rexionmars/kaelix-firmware/docs/TCC/pre-textuais/abrev.tex

%%%%%%%%%%%%%%%%%%%%%%%%%%%%%%%%%%%%%%%%%%%%%%%%%%%%%%%%%%%%%%%%%%%%%%%%%%%%%%%
%% Lista de Siglas e Abreviaturas (pacote glossaries)
%%
%% Contém apenas as siglas efetivamente usadas nas seções 1 a 5 e no apêndice.
%% Acrescentar entrada aqui ao introduzir sigla nova no texto.
%%%%%%%%%%%%%%%%%%%%%%%%%%%%%%%%%%%%%%%%%%%%%%%%%%%%%%%%%%%%%%%%%%%%%%%%%%%%%%%

%% Instrumentação
\newacronym{MEMS}{MEMS}{sistemas microeletromecânicos (\emph{Micro-Electro-Mechanical Systems})}
\newacronym{IMU}{IMU}{unidade de medição inercial (\emph{Inertial Measurement Unit})}
\newacronym{BPFO}{BPFO}{frequência de passagem de esferas na pista externa (\emph{Ball Pass Frequency, Outer race})}
\newacronym{BPFI}{BPFI}{frequência de passagem de esferas na pista interna (\emph{Ball Pass Frequency, Inner race})}
\newacronym{DLPF}{DLPF}{filtro passa-baixas digital (\emph{Digital Low-Pass Filter})}

%% Normalização
\newacronym{ISO}{ISO}{Organização Internacional de Normalização (\emph{International Organization for Standardization})}

%% Detecção e avaliação
\newacronym{ROC}{ROC}{característica de operação do receptor (\emph{Receiver Operating Characteristic})}
\newacronym{AUC}{AUC}{área sob a curva (\emph{Area Under the Curve})}
\newacronym{pAUC}{pAUC}{área parcial sob a curva, restrita a uma faixa de falso alarme}
\newacronym{PRAUC}{PR-AUC}{área sob a curva de precisão e revocação}
\newacronym{TPR}{TPR}{taxa de detecção (\emph{True Positive Rate})}
\newacronym{DFT}{DFT}{transformada discreta de Fourier (\emph{Discrete Fourier Transform})}
\newacronym{FFT}{FFT}{transformada rápida de Fourier (\emph{Fast Fourier Transform})}
\newacronym{FPR}{FPR}{taxa de falso alarme (\emph{False Positive Rate})}

%% Computação embarcada e comunicação
\newacronym{TinyML}{TinyML}{aprendizado de máquina em dispositivos de recursos limitados}
\newacronym{LoRa}{LoRa}{modulação de longo alcance e baixa potência (\emph{Long Range})}
\newacronym{SF}{SF}{fator de espalhamento (\emph{Spreading Factor})}
\newacronym{CRC}{CRC}{verificação cíclica de redundância (\emph{Cyclic Redundancy Check})}
\newacronym{SRAM}{SRAM}{memória estática de acesso aleatório (\emph{Static Random-Access Memory})}
\newacronym{I2C}{I2C}{circuito interintegrado (\emph{Inter-Integrated Circuit})}
\newacronym{SPI}{SPI}{interface serial periférica (\emph{Serial Peripheral Interface})}
\newacronym{USB}{USB}{barramento serial universal (\emph{Universal Serial Bus})}
\newacronym{FIFO}{FIFO}{memória em que o primeiro dado a entrar é o primeiro a sair (\emph{First In, First Out})}
\newacronym{NaN}{NaN}{valor que indica ausência de número (\emph{Not a Number})}

%% Taxas de decisão, descritores e parâmetros do enlace, usados em forma literal no texto.
\newacronym{BW}{BW}{largura de banda (\emph{Bandwidth})}
\newacronym{CR}{CR}{taxa de codificação (\emph{Coding Rate})}
\newacronym{FC}{FC}{fator de crista}
\newacronym{FN}{FN}{falso negativo}
\newacronym{FP}{FP}{falso positivo}
\newacronym{VN}{VN}{verdadeiro negativo}
\newacronym{VP}{VP}{verdadeiro positivo}

%%%%%%%%%%%%%%%%%%%%%%%%%%%%%%%%%%%%%%%%%%%%%%%%%%%%%%%%%%%%%%%%%%%%%%%%%%%%%%%
%% O pacote glossaries só imprime as siglas EFETIVAMENTE USADAS via \gls{...}.
%% Como o texto dos capítulos usa as siglas em forma literal (e não \gls{}),
%% \glsaddall força todas as entradas acima para a lista impressa.
%%
%% Se no futuro o texto passar a usar \gls{}, remova a linha abaixo para que a
%% lista volte a conter apenas o que é citado.
%%%%%%%%%%%%%%%%%%%%%%%%%%%%%%%%%%%%%%%%%%%%%%%%%%%%%%%%%%%%%%%%%%%%%%%%%%%%%%%
\glsaddall
