rexionmars/kaelix-firmware/docs/TCC/pre-textuais/folha-aprovacao.tex

%%%%%%%%%%%%%%%%%%%%%%%%%%%%%%%%%%%%%%%%%%%%%%%%%%%%%%%%%%%%%%%%%%%%%%%%%%%%%%%
%% Folha de aprovação --- modelo iCEV, com os membros da banca (NBR 14724).
%%
%% Depois da defesa, troque o ambiente abaixo pelo PDF da folha assinada:
%%   \usepackage{pdfpages}   (em preambulo/pacotes.tex)
%%   \begin{folhadeaprovacao}
%%     \includepdf{folha-aprovacao-assinada.pdf}
%%   \end{folhadeaprovacao}
%%%%%%%%%%%%%%%%%%%%%%%%%%%%%%%%%%%%%%%%%%%%%%%%%%%%%%%%%%%%%%%%%%%%%%%%%%%%%%%

\begin{folhadeaprovacao}
	\begin{center}
		{\ABNTEXchapterfont\bfseries\imprimirautor}
		\vspace*{\fill}\vspace*{\fill}
		\begin{center}
			\ABNTEXchapterfont\bfseries\imprimirtitulo
		\end{center}
		\vspace*{\fill}
		\icevnatureza
		\vspace*{\fill}
	\end{center}

	\noindent{\bfseries\imprimirlocal, \underline{\hspace{0.8cm}} de \underline{\hspace{2.5cm}} de 20\underline{\hspace{0.5cm}}}

	\assinatura{\bfseries\imprimirorientador \\ Professor Orientador \\ Titulação \\ Instituição}
	\assinatura{\bfseries Membro da banca \\ Titulação \\ Instituição}
	\assinatura{\bfseries Membro da banca \\ Titulação \\ Instituição}
\end{folhadeaprovacao}
