rexionmars/kaelix-firmware/docs/TCC/apendices/appenA.tex

%%%%%%%%%%%%%%%%%%%%%%%%%%%%%%%%%%%%%%%%%%%%%%%%%%%%%%%%%%%%%%%%%%%%%%%%%%%%%%%
%% Apêndice A --- Práticas de engenharia do firmware
%%
%% Valores conferidos em src/sensors/vibration.h, src/comms/lora.h,
%% src/ml/model.h, src/power/watchdog.h e training/tests/test_export_cpp.py.
%%%%%%%%%%%%%%%%%%%%%%%%%%%%%%%%%%%%%%%%%%%%%%%%%%%%%%%%%%%%%%%%%%%%%%%%%%%%%%%

\chapter{Práticas de engenharia do \emph{firmware}}
\label{ape:praticas}

Algumas práticas usadas no \emph{firmware} vêm de normas e da literatura de sistemas críticos.
Essas fontes servem aqui como referência. O Kaelix é um protótipo acadêmico e não passou por
nenhum processo de certificação.

\section{Fontes das práticas}
\label{sec:ape-escalas}

As normas setoriais classificam a criticidade de formas diferentes, e não há equivalência
normativa entre elas. A norma de aviônica classifica o \emph{software} pela severidade da
condição de falha e não atribui taxa de falha ao \emph{software} \cite{do178c}. A norma
genérica define faixas numéricas de medida de falha alvo \cite{iec61508}. A norma automotiva
combina severidade, exposição e controlabilidade \cite{iso26262}.

\section{Práticas adotadas}
\label{sec:ape-mecanismos}

Nenhuma das práticas abaixo exige componente adicional.

\textbf{Propagação de erro.} Cada função devolve um código de estado, e o pacote leva o código do
primeiro erro do ciclo. Sem esse código, uma leitura com falha chegaria ao receptor como uma leitura
normal \cite{esa1996,knight1986}.

\textbf{Saída só em caso de sucesso.} Quando a leitura do sensor falha, a função não escreve no
vetor de amostras. Assim, o detector não recebe zeros que pareçam uma máquina parada.

\textbf{Valor inválido explícito.} O valor eficaz vai como NaN quando não foi medido, porque zero
é uma leitura possível. O estado \texttt{UNKNOWN} indica que o dispositivo não avaliou a máquina.

\textbf{Versão no pacote.} O primeiro byte do pacote informa a versão do formato, e o receptor
recusa versões que não conhece.

\textbf{\emph{Watchdog}.} Um temporizador reinicia o dispositivo se um ciclo travar.

\textbf{Testes no computador.} As funções de processamento rodam sem o \emph{hardware}. Um teste
compara o escore do detector em C++ com o da biblioteca usada no treino, e outro compara o CRC
em C++ com uma implementação em Python.

\section{Limites das práticas}
\label{sec:ape-limites}

Essas práticas não substituem redundância de \emph{hardware}, e a suposição de independência
entre versões diversas de \emph{software} não se confirmou empiricamente \cite{knight1986}. Os
testes no computador não cobrem o comportamento do rádio nem o do sensor.
\emandamento{Nenhum registro de bancada provoca uma falha de propósito para testar a propagação
de erro no dispositivo.}
