rexionmars/kaelix-firmware/docs/guias/guide.md

# Guia de escrita científica

Guia de consulta para escrever e revisar o TCC em português, com uma seção sobre o
*Abstract*. Junta três camadas principais:

1. **Princípios de escrita científica** ensinados por Harvard e pelo MIT, adaptados ao
   português.
2. **Uso de palavras**, segundo o *Manual de Redação da Presidência da República* (3. ed.,
   2018), a referência oficial de norma padrão escrita no Brasil.
3. **Acentuação e hífen**, segundo o Acordo Ortográfico de 1990, obrigatório no Brasil desde
   2016.

Os exemplos de "antes" vêm do próprio TCC sempre que possível. A lista de verificação da
Seção 12 resume tudo para a revisão final. As fontes estão no fim, com o que cada uma
sustenta.

> **"Harvard" também é nome de estilo de referência.** O "Harvard style" é um sistema
> autor-data de citação, comum no Reino Unido. Ele não se aplica aqui: o TCC segue a
> NBR 10520:2023 (citações) e a NBR 6023:2025 (referências), que também são autor-data,
> mas com regras próprias. Este guia trata dos guias de *escrita* de Harvard, não desse
> estilo.

---

## 1. Escreva para o leitor

**Uma mensagem principal.** O guia de artigo do MIT (CommKit) pede que o trabalho tenha
uma mensagem principal que caiba em uma ou duas frases, e que o resumo, as figuras e as
conclusões a contenham explicitamente. Antes de revisar um capítulo, escreva essa frase.
Se não conseguir, o problema não é de redação.

**A maldição do conhecimento.** Steven Pinker, professor de Harvard, chama assim a
dificuldade de imaginar como é *não* saber o que você sabe. É a causa mais comum de texto
técnico obscuro: siglas não definidas, passos "óbvios" omitidos, termos usados antes de
serem explicados. O remédio é pedir a alguém de fora da área que leia e marque onde
travou, o que o CommKit do MIT também recomenda.

**Ajuste o jargão ao público.** O CommKit distingue o público amplo, que precisa de mais
contexto e menos jargão, do especialista, que quer chegar rápido aos métodos. A banca de
um TCC é mista: defina cada termo técnico na primeira ocorrência, mesmo os que parecem
básicos para você.

**Linguagem exata, não linguagem "acadêmica".** O material de escrita do curso 9.12 do
MIT resume a troca de hábito assim: em vez de usar linguagem que *soa* séria e
inteligente, use a que *se ajusta exatamente* ao conteúdo; em vez de cumprir número de
páginas, escreva para comunicar.

---

## 2. Estrutura: do texto inteiro ao parágrafo

### 2.1 Introdução: do geral à lacuna

O CommKit do MIT descreve a introdução como um funil: contexto amplo, contexto
específico, **lacuna de conhecimento**, e então a pergunta ou o objetivo que responde a
ela. Em engenharia, costuma-se formular objetivos; em ciência, perguntas.

O TCC já segue esse desenho no Capítulo 1: norma e custo, depois nó de baixo custo, depois
a lacuna no segundo elo da cadeia, e só então a tese.

### 2.2 Equilíbrio entre seções

O CommKit alerta para a discussão "proporcionalmente longa demais": quando ela cresce,
com muitas citações, o trabalho começa a parecer uma revisão de literatura ou um texto
especulativo. Cada seção deve ter peso compatível com o que sustenta.

### 2.3 Parágrafo: a frase-tópico

Harvard e MIT convergem neste ponto.

- O Writing Center de Harvard dá à frase-tópico **duas funções**: anunciar a ideia
  principal do parágrafo e mostrar como ele se liga ao argumento do texto.
- **Teste de especificidade** (blog do mesmo Writing Center): se a frase-tópico pudesse
  ser transplantada para um texto com outra tese, ela não é específica o bastante.
- O material do MIT diz que o leitor usa a frase-tópico "como se fosse o título" do
  parágrafo. O CommKit acrescenta que o leitor deve captar o ponto principal lendo só a
  primeira frase.

**Teste rápido:** leia apenas a primeira frase de cada parágrafo de um capítulo, em
sequência. Se o argumento fizer sentido assim, a estrutura está boa. Se você tiver pouco
tempo para revisar, o blog do Writing Center de Harvard recomenda revisar exatamente as
frases-tópico.

### 2.4 Organização por afirmações

O Writing Center de Harvard sugere decompor a tese em afirmações principais, cada
afirmação em subafirmações, e conferir se as frases-tópico enunciam essas afirmações. Isso
equivale a escrever o sumário antes do texto e depois verificar se o texto cumpre o
sumário.

### 2.5 Títulos de seção

O material do MIT mostra que uma lista longa de títulos no mesmo nível esconde a
estrutura, e que subtítulos a revelam. Agrupe as seções por função antes de numerá-las.

---

## 3. A frase

### 3.1 Informação velha no início, nova no fim

O artigo de Gopen e Swan, *The Science of Scientific Writing* (1990), é a base de boa
parte do que se ensina em Harvard e no MIT sobre frases.

- **Início da frase (posição de tópico):** a informação já conhecida, que liga a frase à
  anterior.
- **Fim da frase (posição de ênfase):** a informação nova, que você quer que o leitor
  retenha. O leitor dá peso natural ao que vem por último.
- **Sujeito e verbo próximos:** o leitor espera o verbo logo depois do sujeito. Cada
  palavra entre os dois adia o entendimento.

| Antes | Depois |
|---|---|
| A frequência de montagem, que decorre da rigidez do caminho entre a base, o ressalto e o corpo e da massa do conjunto, situa-se em 557 Hz. | A rigidez do caminho e a massa do conjunto situam a frequência de montagem em 557 Hz. |

Na segunda versão, sujeito e verbo ficam juntos, e o número novo, 557 Hz, cai na posição
de ênfase.

### 3.2 Uma ideia por frase

Gopen e Swan observam que uma frase fica longa demais quando tem mais candidatos à
posição de ênfase do que posições disponíveis. Se a frase tem dois números importantes,
provavelmente são duas frases.

### 3.3 Paralelismo

Itens de uma lista ou de uma comparação devem ter a mesma forma gramatical. O *Manual de
Redação* (seção 11.4) dedica uma seção aos erros de paralelismo.

| Antes | Depois |
|---|---|
| O método compara a integração no tempo, a integração na frequência e se o viés altera o resultado. | O método compara a integração no tempo, a integração na frequência e o efeito do viés sobre o resultado. |

---

## 4. Concisão e escolha de palavras

### 4.1 Corte palavras que não trabalham

Esta tabela adapta ao português as listas do curso do MIT ("needless complexity" e
"needless words"). Ela também segue o *Manual de Redação* (seção 3.3): conciso é o texto
que transmite o máximo de informação com o mínimo de palavras, sem cortar o que é
substancial.

| Evite | Prefira |
|---|---|
| realizar a medição de | medir |
| efetuar a análise de | analisar |
| fazer a implementação de | implementar |
| tomar a decisão de | decidir |
| possui a capacidade de | pode |
| a utilização de | o uso de |
| com o objetivo de | para |
| devido ao fato de que | porque |
| no presente trabalho | neste trabalho |
| já existente | existente |
| continua a permanecer | permanece |
| completamente eliminado | eliminado |
| período de tempo | período |
| em um primeiro momento | primeiro |
| elo de ligação | elo |

O MIT chama de **verbos fracos** construções como "fazer a medição" ou "realizar o
desenvolvimento". O verbo forte ("medir", "desenvolver") é mais curto e mais claro.

### 4.2 Adjetivos e advérbios de ênfase

O *Manual de Redação* (seção 3.3) mostra um parágrafo inflado por "impressionante",
"esmagadora" e "indubitável" e o reescreve sem eles. Em texto científico, o número
substitui o adjetivo:

| Antes | Depois |
|---|---|
| A integração no tempo erra enormemente. | A integração no tempo erra em 73 %. |
| O detector tem desempenho muito ruim em desalinhamento. | O detector detecta 5,0 % ± 3,1 % do desalinhamento horizontal. |

O CommKit do MIT faz a mesma exigência para o resumo: resultados quantificados, e não
descritos em termos gerais.

### 4.3 Voz ativa, voz passiva e impessoalidade

O MIT recomenda a voz ativa por ser mais curta e mais direta. O exemplo do curso é "The
oscilloscope displayed the voltage", em vez de "The voltage was displayed by the
oscilloscope". O guia da Biblioteca de Harvard acrescenta que a passiva pode esconder
quem é responsável pela ação. Os dois admitem a passiva quando o agente não importa, o
que é comum em métodos.

Em português acadêmico há uma exigência a mais, a impessoalidade (*Manual de Redação*,
seção 3.5). A solução que atende as duas é a **voz ativa com sujeito inanimado**:

| Evite | Prefira |
|---|---|
| Nós medimos o falso alarme e vimos que... | O falso alarme medido foi de 2,0 %... |
| Foi verificado, por meio da análise realizada, que... | A análise mostra que... |
| Pode-se observar na Tabela 3 que... | A Tabela 3 mostra que... |

O *Manual de Redação* também condena o abuso do pronome "se" como indeterminador ("para
se atingir-se..."): o infinitivo sozinho já é impessoal. Escolha um registro, terceira
pessoa ou primeira do plural, e mantenha-o no trabalho inteiro.

**Tempo verbal.** Na prática comum dos guias de escrita científica, introdução e
discussão ficam no presente, para o que é tomado como verdade geral ("a norma exige"), e
métodos e resultados no pretérito perfeito, para o que foi feito ("o detector marcou").

### 4.4 Expressões a evitar

Todas as entradas desta tabela estão na seção 12.2 do *Manual de Redação*, salvo
indicação em contrário.

| Evite | Prefira | Observação |
|---|---|---|
| "o mesmo" como pronome ("o sensor falhou e o mesmo foi trocado") | ele, este, ou elimine | Gera ambiguidade. "O mesmo modelo" (adjetivo) está correto. |
| "onde" sem ideia de lugar ("a lei onde se fixa a pena") | em que, no qual | "Onde" é só para lugar físico. "Frequência onde nada existe" → "frequência em que nada existe". |
| "a nível de" | em nível de, no que se refere a | Modismo. |
| "a partir de" sem sentido de tempo ("a partir das cotas do desenho") | com base em | O Manual reserva a expressão para o sentido temporal. |
| "face a" | em face de, diante de | |
| "enquanto que" | enquanto, ao passo que | |
| "inclusive" com sentido de "até" | até, também | |
| "junto a" fora do sentido físico ("declarar junto à Receita") | declarar à Receita | |
| "nem tampouco", "não... nem não" | nem | Dupla negação. |
| "posto que" como causa | porque, já que | "Posto que" é concessivo: significa "embora". |
| "à medida em que", "na medida que" | à medida que (proporção); na medida em que (causa) | Cruzamento de duas locuções. |
| "operacionalizar", "agilizar" repetidos | realizar, executar, fazer | O problema é o excesso. |

**"Cerca de" com número não redondo.** O *Manual de Redação* (seção 12.1) diz que "cerca
de" indica número aproximado ou arredondado e não deve acompanhar números que não sejam
redondos. O TCC tinha casos assim, corrigidos na revisão de 30 out. 2026:

| No TCC (antes) | Revisão |
|---|---|
| dissipa cerca de 0,41 W | dissipa até 0,41 W (ou: aproximadamente 0,41 W) |
| a resolução é de cerca de 1,95 Hz | a resolução é de 1,95 Hz (valor calculado, 1000/512, apenas arredondado) |
| cerca de 0,063 m/s² | aproximadamente 0,063 m/s² |
| acima de cerca de 3,3 kHz | acima de aproximadamente 3,3 kHz |

### 4.5 Parônimos que mudam o sentido

| Forma | Significa | Exemplo |
|---|---|---|
| **a fim de** | para, com a finalidade de | Decimou-se o sinal a fim de emular a banda. |
| **afim** | semelhante, relacionado | Áreas afins. |
| **acerca de** | sobre, a respeito de | Discute-se acerca do limiar. |
| **há cerca de** | faz aproximadamente | O sensor foi lançado há cerca de dez anos. |
| **em vez de** | em lugar de | Usou-se a pAUC em vez da AUC. |
| **ao invés de** | ao contrário de (oposição) | Ao invés de melhorar, o desempenho caiu. |
| **a princípio** | no começo | A princípio, supôs-se que o invólucro limitava. |
| **em princípio** | em tese | Em princípio, o método vale para qualquer banda. |
| **há** (tempo passado) | faz | O ensaio ocorreu há dois meses. |
| **a** (tempo futuro, distância) | daqui a | O ensaio ocorrerá daqui a dois meses. |
| **mau** / **mal** | adjetivo (oposto de bom) / advérbio (oposto de bem) | Mau contato; o sensor está mal fixado. |
| **senão** / **se não** | caso contrário, exceto / caso não | Configure o filtro, senão há rebatimento. Se não configurar o filtro, há rebatimento. |

As seis primeiras estão na seção 12.1 do Manual, e o par a princípio/em princípio na
seção 12.2. Os pares há/a, mau/mal e senão/se não seguem a norma padrão geral.

### 4.6 Estrangeirismos e itálico

O *Manual de Redação* (seção 10.2) manda pôr em itálico as palavras estrangeiras **não
incorporadas** ao português. Ele também cita exemplos que dispensam destaque porque já
são de uso comum (internet, mouse, déficit). O que importa é a consistência.

O TCC era inconsistente: *software* estava sempre em itálico, e hardware, firmware e
benchmark nunca. Havia duas regras possíveis:

- **Opção A:** itálico em todos os termos em inglês (*software*, *hardware*,
  *firmware*, *benchmark*, *pipeline*, *standby*).
- **Opção B:** sem itálico para os termos já consagrados em engenharia (software,
  hardware, firmware) e itálico para os demais.

**Decisão (30 out. 2026): opção A**, aplicada ao texto inteiro. Termo novo em inglês
entra em itálico.

Não ponha itálico em nomes próprios, siglas e nomes de produto (Isolation Forest, LoRa,
ESP32-S3).

### 4.7 Siglas

Escreva por extenso na primeira ocorrência, com a sigla entre parênteses: "unidade de
medição inercial (IMU)". Depois use só a sigla. O CommKit do MIT pede que **legendas de
figura** também definam toda sigla e símbolo, porque a legenda deve ser lida sem o texto.
No TCC, a lista de siglas vem de `pre-textuais/abrev.tex`.

---

## 5. Figuras, tabelas e legendas

As regras do CommKit do MIT para figuras:

1. A figura deve se explicar sozinha. Pergunte se a mensagem principal fica clara só pela
   figura.
2. A legenda deve explicar a figura sem depender do texto.
3. Defina na legenda toda sigla e todo símbolo, e evite siglas quando puder.
4. Faça figuras preliminares cedo: elas revelam onde faltam testes ou experimentos.

Para o desenho em si (normas ISO e ABNT de desenho técnico, cor, unidades), siga
o guia de plotagem.

---

## 6. Uso de fontes

O *Harvard Guide to Using Sources* organiza o uso de fontes em três formas: **resumir**,
**parafrasear** e **citar literalmente**. Segundo a descrição do guia, as ciências
naturais usam sobretudo resumo e paráfrase; a citação literal fica para quando a
formulação exata importa, como na definição de uma norma.

Regras práticas:

- **Toda forma exige atribuição.** Paráfrase sem citação é plágio, mesmo com outras
  palavras.
- **Paráfrase de verdade** muda a estrutura, não só as palavras. Feche a fonte, escreva de
  memória e só depois confira.
- **Citação literal curta** (até três linhas) fica no corpo do texto, entre aspas. A
  longa vai em bloco recuado; desde a NBR 10520:2023, o recuo de 4 cm é recomendado, e
  não obrigatório.
- **Citação traduzida por você** leva "tradução nossa" na chamada: (Gopen; Swan, 1990,
  p. 552, tradução nossa).
- **Cite o que você leu.** Se só leu o resumo, diga isso. O TCC já faz isso nas notas das
  referências ("Texto integral não acessado").

---

## 7. Acentuação e hífen

### 7.1 O que o Acordo de 1990 mudou

As regras e os exemplos desta seção vêm do tutorial da reforma ortográfica da Câmara dos
Deputados.

| Regra | Antes | Agora |
|---|---|---|
| Ditongos abertos **éi** e **ói** em paroxítonas perdem o acento | idéia, heróico, assembléia, apóio | ideia, heroico, assembleia, apoio |
| **i** e **u** tônicos depois de ditongo, em paroxítonas, perdem o acento | feiúra, Bocaiúva | feiura, Bocaiuva |
| Terminações **êem** e **ôo(s)** perdem o acento | lêem, crêem, vôo, perdôo | leem, creem, voo, perdoo |
| Somem os acentos diferenciais pára, péla, pólo, pêlo, pêra | Ele pára o carro. | Ele para o carro. |
| O trema desaparece (exceto em nomes estrangeiros: Müller) | freqüência, tranqüilo, cinqüenta | frequência, tranquilo, cinquenta |

**O que continua acentuado:**

- **Oxítonas e monossílabos com éi, éu, ói** continuam acentuados: herói, troféu, papéis,
  dói. A regra que caiu vale só para paroxítonas.
- **i e u tônicos em posição final de oxítona** continuam: Piauí, tuiuiú.
- **pôde** (passado) × **pode** (presente): "Ontem ele não pôde sair, mas hoje pode."
- **pôr** (verbo) × **por** (preposição).
- **Plural de ter e vir e derivados:** ele tem / eles têm; ele vem / eles vêm; ele mantém
  / eles mantêm; ele contém / eles contêm.
- **fôrma** × forma: o acento é facultativo.

### 7.2 As regras básicas, para não errar por omissão

O erro mais comum em texto digitado é a falta de acento, e não o acento errado.

- **Proparoxítonas:** todas são acentuadas. Exemplos: análise, técnica, científica,
  média, módulo, índice, código, dígito, protótipo, máquina, numérico, término, síntese,
  próximo, físico.
- **Paroxítonas** são acentuadas quando terminam em:

  | Terminação | Exemplos |
  |---|---|
  | -l | útil, fácil, possível, variável, nível, móvel |
  | -n | hífen, pólen |
  | -r | caráter, éter |
  | -x | tórax |
  | -ps | bíceps |
  | -ã(s), -ão(s) | ímã, ímãs, órgão |
  | -i(s), -us | lápis, vírus, bônus |
  | -um, -uns | álbum |
  | ditongo | frequência, série, água, área, espécie, rádio |

  **Não** se acentuam paroxítonas terminadas em -a, -e, -o, -em, -ens: medida, rede,
  modelo, item, itens. Por isso o singular leva acento e o plural não: hífen/hifens,
  pólen/polens.
- **Oxítonas** são acentuadas quando terminam em -a(s), -e(s), -o(s), -em, -ens: até,
  após, também, porém, através, alguém, parabéns.

### 7.3 Palavras do TCC que costumam perder o acento

> análise · técnica · científica · frequência · média · índice · módulo · código ·
> protótipo · rolamento (sem acento) · vibração · aquisição · precisão · resolução ·
> elétrico · térmico · mecânico · estatístico · espectral (sem acento) · amplitude (sem
> acento) · ímã/ímãs · têm/tem · contém/contêm · pôde · experiência · referência ·
> eficiência · potência · tensão · ressonância · hipótese · síntese · conclusão ·
> padrões · possível · útil · único · só · já · até · também · após · através

### 7.4 Hífen com prefixo

Pelo tutorial da Câmara e pela regra geral do Acordo:

| Regra | Exemplos |
|---|---|
| Prefixo terminado em vogal + palavra iniciada por **r** ou **s**: **sem hífen**, dobra a consoante | antirrebatimento, antirruído, autossustentável, semissupervisionado, contrarregra |
| Prefixo terminado em vogal + palavra iniciada por **vogal diferente**: sem hífen | autoaquecimento, extraoficial, infraestrutura, semiautomático |
| Prefixo terminado em vogal + **mesma vogal**: com hífen | micro-ondas, anti-inflamatório, semi-interno |
| Palavra iniciada por **h**: com hífen | anti-higiênico, super-homem |
| **pré-, pós-, pró-** tônicos: sempre com hífen | pré-carga, pós-processamento |
| sub- + **b** ou **r**: com hífen | sub-base, sub-região (mas subamostragem) |

**No TCC:** "anti-rebatimento" aparecia duas vezes e foi corrigido para
"**antirrebatimento**" em 30 out. 2026. "Pré-carga", "autoaquecimento" e
"semissupervisionada" já estavam corretos.

### 7.5 Crase

A crase é a fusão da preposição **a** com o artigo **a**. O teste é trocar a palavra
feminina por uma masculina: se aparecer "ao", há crase.

- **Há crase:** "relativo à banda" (relativo ao sinal); "à medida que"; "às vezes"; "devido
  à temperatura" (devido ao calor).
- **Não há crase** antes de palavra masculina ("a partir do ensaio"), de verbo ("começou a
  medir"), de pronome pessoal ("refere-se a ela") e em "a partir de", com qualquer
  palavra.
- **Regência:** "ajustar **às** normas", "adequar **à** NBR 6023": "ajustar a" + "as
  normas".

---

## 8. Números, unidades e símbolos

Estas regras seguem a brochura do SI (BIPM, 9. ed., 2019). No TCC, o `siunitx` aplica a
maioria delas sozinho, desde que se use `\SI{...}{...}` e `\num{...}`.

- **Vírgula decimal:** 0,5, e não 0.5.
- **Espaço entre número e unidade:** 15 kW, 557 Hz. No LaTeX: `\SI{557}{\hertz}`.
- **O símbolo de porcentagem também leva espaço:** 2,0 %. No LaTeX: `\SI{2,0}{\percent}`.
- **Símbolos de unidade não têm plural nem ponto:** 5 kg, e não "5 kgs" nem "5 kg.".
- **Grandeza em itálico, unidade em redondo:** *f*<sub>n</sub> = 557 Hz.
- **Faixas:** "10 Hz a 1000 Hz", ou `\SIrange{10}{1000}{\hertz}`.
- **Incerteza:** a unidade precisa valer para os dois números: (75,0 ± 3,5) % ou
  75,0 % ± 3,5 %. A forma "75,0 ± 3,5 %" deixa a unidade só no segundo número. **Decisão
  (30 out. 2026):** o TCC usa "(75,0 ± 3,5) %", já configurado no `\sisetup` de
  `preambulo/pacotes.tex`; basta escrever `\SI{75,0 \pm 3,5}{\percent}`. No `siunitx`, `\SI{75,0 \pm 3,5}{\percent}` sai, por padrão, como
  "75,0(35) %". Com `uncertainty-mode = separate` e `separate-uncertainty-units = bracket`
  no `\sisetup`, sai "(75,0 ± 3,5) %"; com `= repeat`, sai "75,0 % ± 3,5 %". As duas
  formas foram testadas.
- **Por extenso ou com símbolo, nunca misturado:** "15 quilowatts" ou "15 kW", e não
  "15 quilo-W".
- **Números no início da frase** (convenção de estilo, não do SI): escreva por extenso ou
  reescreva a frase. "Quarenta dos 41 estudos...", ou "Dos 41 estudos, 40...".

---

## 9. Abstract em inglês

### 9.1 Estrutura

O CommKit do MIT divide o resumo em seis componentes, de poucas frases cada, somando
"algumas centenas de palavras":

1. **Contexto amplo**, que interessa a todo o público.
2. **Contexto específico**, que leva ao seu problema.
3. **Lacuna:** qual é a pergunta de pesquisa?
4. **Frase de solução:** o que você fez e como responde à lacuna. O guia sugere começar
   com "Here we show".
5. **Abordagem e resultados**, com números.
6. **Implicações:** por que importa e o que vem depois.

O resumo deve ser compreensível sem o resto do trabalho: a maioria dos leitores decide
pelo título e pelo resumo.

### 9.2 Falsos cognatos comuns em texto técnico

| Português | Inglês correto | Armadilha |
|---|---|---|
| atualmente | currently | *actually* = na verdade |
| eventualmente (às vezes) | occasionally | *eventually* = por fim |
| realizar (um ensaio) | carry out, perform, run | *realize* = perceber |
| pretender | intend | *pretend* = fingir |
| sensível | sensitive | *sensible* = sensato |
| norma (técnica) | standard | *norm* = norma social |
| assistir | watch, attend | *assist* = ajudar |
| dado(s) | data (plural), a data point | *datum* é raro |
| bancada de ensaio | test rig, test bench | |
| ensaio | test | *essay* = redação |
| tese (TCC) | thesis, capstone project | |

### 9.3 Consistência de grafia

O *Abstract* atual usa grafia britânica (*standardised*, *synthesised*, *modelling*).
Está correta, mas precisa ser consistente: uma única palavra americana (*standardized*,
*modeling*) quebra o padrão. Escolha uma variante e mantenha-a no texto inteiro.

---

## 10. Normas ABNT que tocam a redação

- **Citações (NBR 10520:2023):** autor em caixa alta e baixa, também entre parênteses
  (Liu; Ting; Zhou, 2008); *et al.* e *apud* em itálico. O estilo
  `abntex2-alf-2025.bst` já faz isso; não escreva citações à mão.
- **Referências (NBR 6023:2025):** DOI como endereço completo, "Acesso em" só para página
  web. As convenções do `.bib` estão no cabeçalho de `referencias.bib`.
- **"Capítulo" ou "seção" (NBR 14724:2024):** fontes secundárias indicam que a edição de
  2024 adota só "seção", seguindo a NBR 6024. O TCC diz "Capítulo~\ref{...}" em 12
  lugares. **Confirme no texto da norma, ou com o orientador**, antes de trocar.
- **Resumo (NBR 6028:2021):** parágrafo único, voz ativa, sem citações, palavras-chave
  separadas por ponto e vírgula.

---

## 11. Erros recorrentes nas suas mensagens

Os padrões abaixo apareceram nas mensagens desta conversa, e não no TCC. Eles valem como
lista de autoconferência para quando você escreve rápido.

| Escrito | Correto | Regra |
|---|---|---|
| so, unico, monolitico, referencias, cientifica, padroes | só, único, monolítico, referências, científica, padrões | Acento omitido (7.2 e 7.3) |
| matendo | mantendo | Ortografia |
| afim de | a fim de | Parônimo (4.5) |
| ajusta as referências **para** as normas | ajuste as referências **às** normas | Regência e crase (7.5) |
| havard, pdf | Harvard, PDF | Nome próprio e sigla em maiúsculas |
| Analisa, pra | Analise, para | Registro: aceitável em conversa, não no texto formal |

O primeiro item é de longe o mais frequente. Ao revisar, faça uma passada só para acentos,
procurando as palavras da lista 7.3.

---

## 12. Lista de verificação

**Estrutura**
- [ ] A mensagem principal cabe em uma ou duas frases e aparece no resumo, nas figuras e
      nas conclusões.
- [ ] A introdução vai do contexto amplo à lacuna e só então à pergunta ou ao objetivo.
- [ ] Lendo só as frases-tópico de um capítulo, o argumento se sustenta.
- [ ] A discussão não domina o trabalho.

**Frase**
- [ ] Sujeito e verbo estão próximos.
- [ ] A informação nova está no fim da frase.
- [ ] Os itens de cada lista têm a mesma forma gramatical.
- [ ] Nenhuma frase carrega dois números importantes que deveriam estar separados.

**Palavras**
- [ ] Sem verbos fracos ("realizar a medição") nem expressões infladas (tabela 4.1).
- [ ] Adjetivos de ênfase foram trocados por números.
- [ ] Sem "o mesmo" como pronome, "onde" sem lugar, "a nível de", "a partir de" sem tempo.
- [ ] "Cerca de" só com número redondo.
- [ ] Itálico em estrangeirismos aplicado com uma regra única.
- [ ] Toda sigla está definida na primeira ocorrência e na legenda das figuras.

**Grafia**
- [ ] Passada só de acentos (lista 7.3).
- [ ] Hífen de prefixos conferido: antirrebatimento, e não anti-rebatimento.
- [ ] Crase conferida pelo teste do masculino.
- [ ] Unidades com `\SI`, vírgula decimal e espaço antes da unidade e do %.

**Fontes**
- [ ] Toda paráfrase tem citação.
- [ ] Citações traduzidas levam "tradução nossa".
- [ ] Nenhuma citação escrita à mão: tudo passa por `\cite` ou `\citeonline`.

**Abstract**
- [ ] Segue os seis componentes do CommKit e dá números.
- [ ] Sem falsos cognatos (tabela 9.2).
- [ ] Grafia britânica ou americana, nunca as duas.

---

## Fontes

Consultadas em 29 e 30 out. 2026.

**Harvard**

- HARVARD COLLEGE WRITING CENTER. *Anatomy of a Body Paragraph*. Fonte das duas funções
  da frase-tópico. https://writingcenter.fas.harvard.edu/anatomy-body-paragraph
- HARVARD COLLEGE WRITING CENTER. *Tips for Organizing Your Essay*. Fonte da
  decomposição da tese em afirmações.
  https://writingcenter.fas.harvard.edu/tips-organizing-your-essay
- HARVARD COLLEGE WRITING CENTER. *When you don't have much time to revise, focus on topic
  sentences*. Blog, 3 set. 2020. Fonte do teste de especificidade.
  https://harvardwritingcenterblog.com/2020/09/03/when-you-dont-have-much-time-to-revise-focus-on-topic-sentences/
- HARVARD COLLEGE WRITING PROGRAM. *Harvard Guide to Using Sources*. Fonte das três
  formas: resumo, paráfrase e citação.
  https://www.library.hbs.edu/citations/harvard-guide-to-using-sources
- HARVARD LIBRARY. *Writing Guide*. Fonte da voz ativa e do problema da
  responsabilidade oculta na passiva. https://library.harvard.edu/writing-guide
- PINKER, S. *The Sense of Style: the thinking person's guide to writing in the 21st
  century*. New York: Viking, 2014. Pinker é professor de psicologia em Harvard; fonte da
  "maldição do conhecimento".

Os sites do FAS de Harvard bloqueiam acesso automatizado. O conteúdo das três páginas do
Writing Center veio dos resumos indexados por mecanismos de busca, e não da leitura
integral das páginas.

**MIT**

- MIT COMMUNICATION LAB. *CommKit: Journal article*. Department of Civil and
  Environmental Engineering. Fonte da mensagem principal, das figuras autossuficientes, do
  peso das seções e da frase-tópico como resumo do parágrafo.
  https://mitcommlab.mit.edu/cee/commkit/journal-article/
- MIT COMMUNICATION LAB. *CommKit: Abstract*. Fonte dos seis componentes do resumo.
  https://mitcommlab.mit.edu/cee/commkit/abstract/
- OGREN, M. P. *Writing basics*. Material do curso 9.12, Experimental Molecular
  Neurobiology, MIT OpenCourseWare, 2006. Fonte das listas de palavras desnecessárias,
  dos verbos fracos, da voz ativa e da frase-tópico como título.
  https://ocw.mit.edu/courses/9-12-experimental-molecular-neurobiology-fall-2006/resources/writingbasics/
- PERELMAN, L.; BARRETT, E. *The Mayfield Handbook of Technical and Scientific Writing*.
  Burr Ridge: McGraw-Hill Higher Education, 1997. Recomendado no material do curso 9.12,
  com esta referência.

**Base comum**

- GOPEN, G. D.; SWAN, J. A. The science of scientific writing. *American Scientist*,
  v. 78, n. 6, p. 550-558, 1990. Fonte das posições de tópico e de ênfase e da proximidade
  entre sujeito e verbo. JSTOR 29774235.

**Português e normas**

- BRASIL. Presidência da República. *Manual de redação da Presidência da República*. 3.
  ed. Brasília: Presidência da República, 2018. Fonte dos atributos (seção 3), do itálico
  (10.2), do paralelismo (11.4), dos parônimos (12.1) e das expressões a evitar (12.2).
  Lido nesta cópia, de 189 páginas:
  https://files.ufgd.edu.br/arquivos/arquivos/78/PROTOCOLO/Normas%20Internas/Manual%20de%20Reda%C3%A7%C3%A3o%20da%20Presid%C3%AAncia%20da%20Rep%C3%BAblica%20-%203%C2%A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,%20revista,%20atualizada%20e%20ampliada.pdf
  A versão oficial é distribuída pelo Portal da Legislação (planalto.gov.br).
- CÂMARA DOS DEPUTADOS. *Tutorial: reforma ortográfica*. Brasília. Fonte das regras e dos
  exemplos da seção 7.
  https://www.camara.leg.br/internet/reformaortografica/versao_impressao_tutorial_ortografico.pdf
- BUREAU INTERNATIONAL DES POIDS ET MESURES. *The International System of Units (SI)*.
  9. ed. Sèvres: BIPM, 2019. Fonte da seção 8. https://www.bipm.org/en/publications/si-brochure
- ASSOCIAÇÃO BRASILEIRA DE NORMAS TÉCNICAS. NBR 10520:2023, NBR 6023:2025, NBR 6028:2021
  e NBR 14724:2024. Para as mudanças de 2023 e 2025, ver a revisão das referências feita
  em 29 out. 2026 e o cabeçalho de `abntex2-alf-2025.bst`.
