rexionmars/kaelix-firmware/experiments/figures/data/fig2e_roc.csv

fpr | tpr | auc | pauc | pauc_05 | banda | banda_curta
0.0 | 0.0 | 0.9997959183673469 | 0.9989258861439312 | 0.9979068550497121 | Sensor 20 kHz AUC 1.000 · pAUC 0.999 | Sensor 20 kHz
0.0 | 0.007142857142857143 | 0.9997959183673469 | 0.9989258861439312 | 0.9979068550497121 | Sensor 20 kHz AUC 1.000 · pAUC 0.999 | Sensor 20 kHz
0.0 | 0.02857142857142857 | 0.9997959183673469 | 0.9989258861439312 | 0.9979068550497121 | Sensor 20 kHz AUC 1.000 · pAUC 0.999 | Sensor 20 kHz
0.0 | 0.04285714285714286 | 0.9997959183673469 | 0.9989258861439312 | 0.9979068550497121 | Sensor 20 kHz AUC 1.000 · pAUC 0.999 | Sensor 20 kHz
0.0 | 0.06428571428571428 | 0.9997959183673469 | 0.9989258861439312 | 0.9979068550497121 | Sensor 20 kHz AUC 1.000 · pAUC 0.999 | Sensor 20 kHz
0.0 | 0.12857142857142856 | 0.9997959183673469 | 0.9989258861439312 | 0.9979068550497121 | Sensor 20 kHz AUC 1.000 · pAUC 0.999 | Sensor 20 kHz
0.0 | 0.21428571428571427 | 0.9997959183673469 | 0.9989258861439312 | 0.9979068550497121 | Sensor 20 kHz AUC 1.000 · pAUC 0.999 | Sensor 20 kHz
0.0 | 0.22142857142857142 | 0.9997959183673469 | 0.9989258861439312 | 0.9979068550497121 | Sensor 20 kHz AUC 1.000 · pAUC 0.999 | Sensor 20 kHz
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
