rexionmars/kaelix-firmware/experiments/figures/data/tab_deteccao_classes.csv

classe | massa_g | deteccao | desvio | janelas
horizontal-misalignment |  | 0.05012820512820513 | 0.030738232248488182 | 1773
imbalance |  | 0.7496708377305392 | 0.035370258014343056 | 2997
normal |  | 0.02 | 0.012957670877434 | 441
overhang-bearing |  | 0.4221799183535334 | 0.07781150889452515 | 4617
overhang-bearing | 0 | 0.20702973909870465 | 0.0699817591259201 | 1323
overhang-bearing | 20 | 0.6396296296296297 | 0.07758415051750346 | 1107
overhang-bearing | 35 | 0.7832804232804234 | 0.08224499694795837 | 918
overhang-bearing | 6 | 0.1952198503922642 | 0.09623218379701658 | 1269
underhang-bearing |  | 0.5589482339482339 | 0.033446286755102986 | 5022
underhang-bearing | 0 | 0.14848020434227333 | 0.04304839017047613 | 1332
underhang-bearing | 20 | 0.8198321474183542 | 0.02764438907339779 | 1323
underhang-bearing | 35 | 0.8728260869565216 | 0.05492188027801067 | 1053
underhang-bearing | 6 | 0.4617879948914432 | 0.04302851629775429 | 1314
vertical-misalignment |  | 0.07161505768063145 | 0.04276832724824457 | 2709
