rexionmars/kaelix-firmware/experiments/figures/data/fig2d_fora_do_treino.csv

ensaio_retido | contamination | falso_alarme
0 | auto | 1.0
0 | 0.01 | 1.0
1 | auto | 1.0
1 | 0.01 | 1.0
2 | auto | 1.0
2 | 0.01 | 1.0
3 | auto | 1.0
3 | 0.01 | 1.0
4 | auto | 1.0
4 | 0.01 | 1.0
