rexionmars/kaelix-firmware/experiments/figures/data/tab_deteccao_limiar.csv

limiar | falso_alarme | desvio
calibrado | 0.02 | 0.012957670877434
padrão | 0.31234567901234567 | 0.04243035840926408
