rexionmars/kaelix-firmware/experiments/figures/output/fig8_circuito_folha2.png

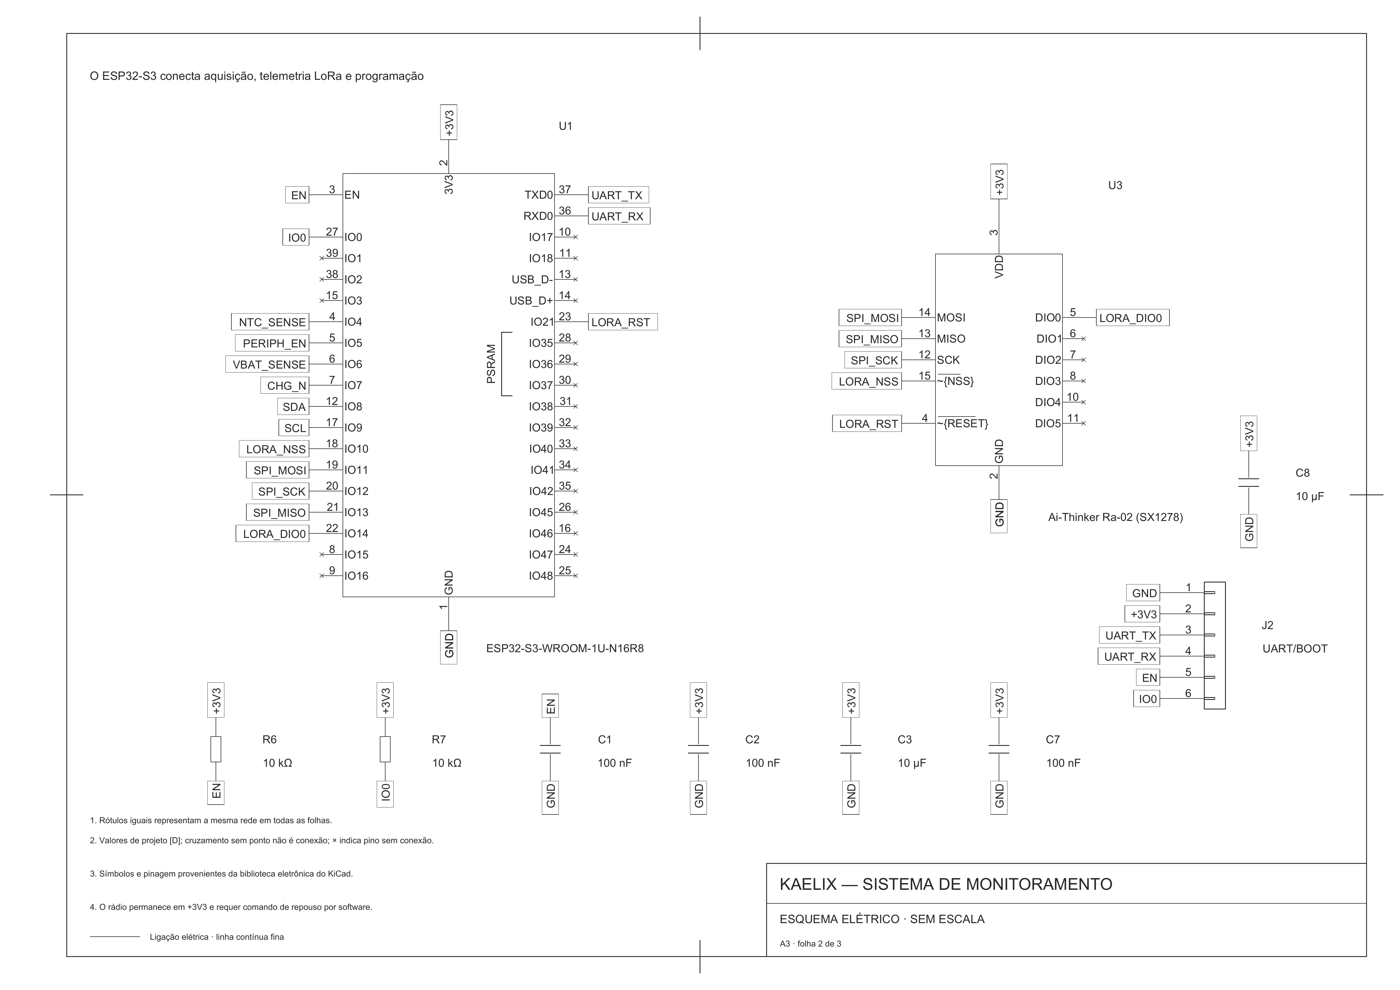
experiments/figures/output/fig8_circuito_folha2.png
