rexionmars/kaelix-firmware/experiments/figures/output/fig8_circuito_folha3.png

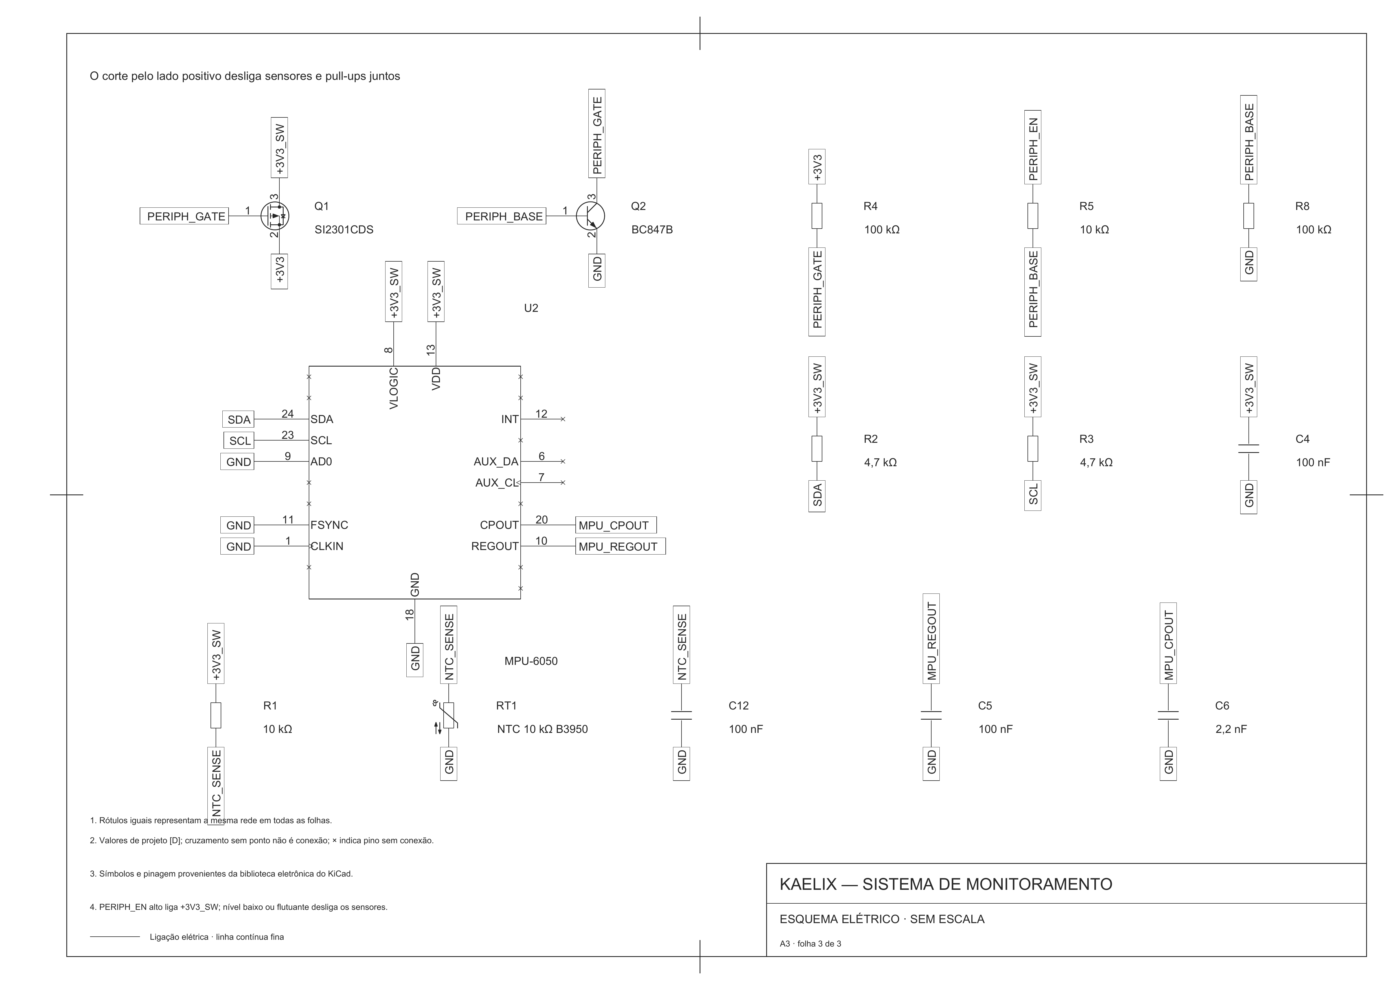
experiments/figures/output/fig8_circuito_folha3.png
