rexionmars/kaelix-firmware/experiments/figures/output/fig1_banda_sensor.pdf

a

b

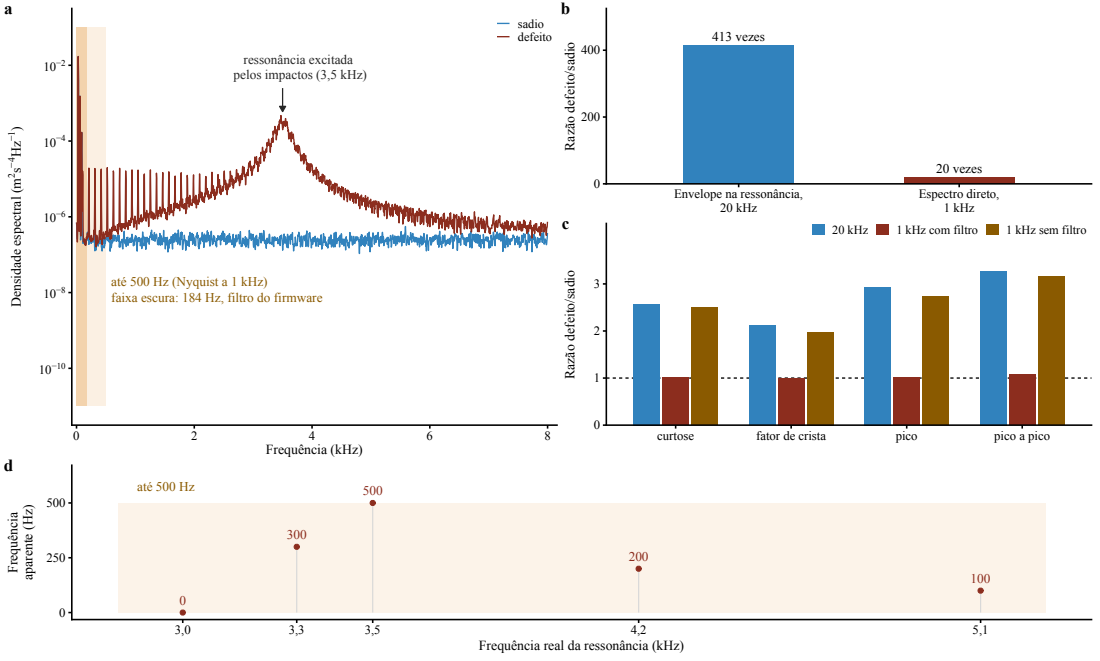
[picture p5: page 1]
Frequência (kHz); Densidade espectral (m2; sadio defeito; 413 vezes; 20 vezes; 20 kHz; Espectro direto, 1 kHz; curtose; fator de crista; pico; pico a pico; 1 kHz com filtro; 1 kHz sem filtro c; até 500 Hz; Frequência; aparente (Hz)

Razão defeito/sadio

ressonância excitada
pelos impactos (3,5 kHz)

Envelope na ressonância,

até 500 Hz (Nyquist a 1 kHz)
faixa escura: 184 Hz, filtro do firmware

Frequência real da ressonância (kHz)
