rexionmars/kaelix-firmware/experiments/figures/output/fig2_metodologia.pdf

a

b

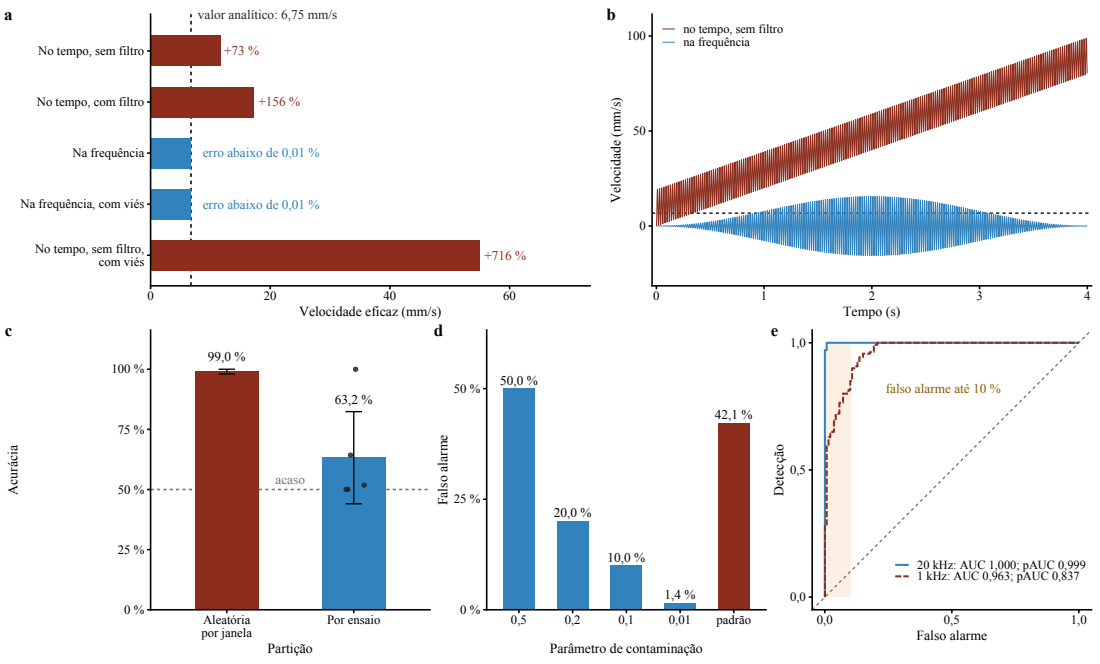
[picture p6: page 1]
com viés; Na frequência; Tempo (s); Velocidade (mm/s); acaso; Aleatória por janela; Por ensaio; Partição; Acurácia c; padrão; Falso alarme; Detecção

valor analítico: 6,75 mm/s

no tempo, sem filtro
na frequência

No tempo, sem filtro

No tempo, com filtro

erro abaixo de 0,01 %

Na frequência, com viés

No tempo, sem filtro,

Velocidade eficaz (mm/s)

falso alarme até 10 %

20 kHz: AUC 1,000; pAUC 0,999
1 kHz: AUC 0,963; pAUC 0,837

Parâmetro de contaminação
