rexionmars/kaelix-firmware/experiments/figures/output/fig8_circuito.pdf

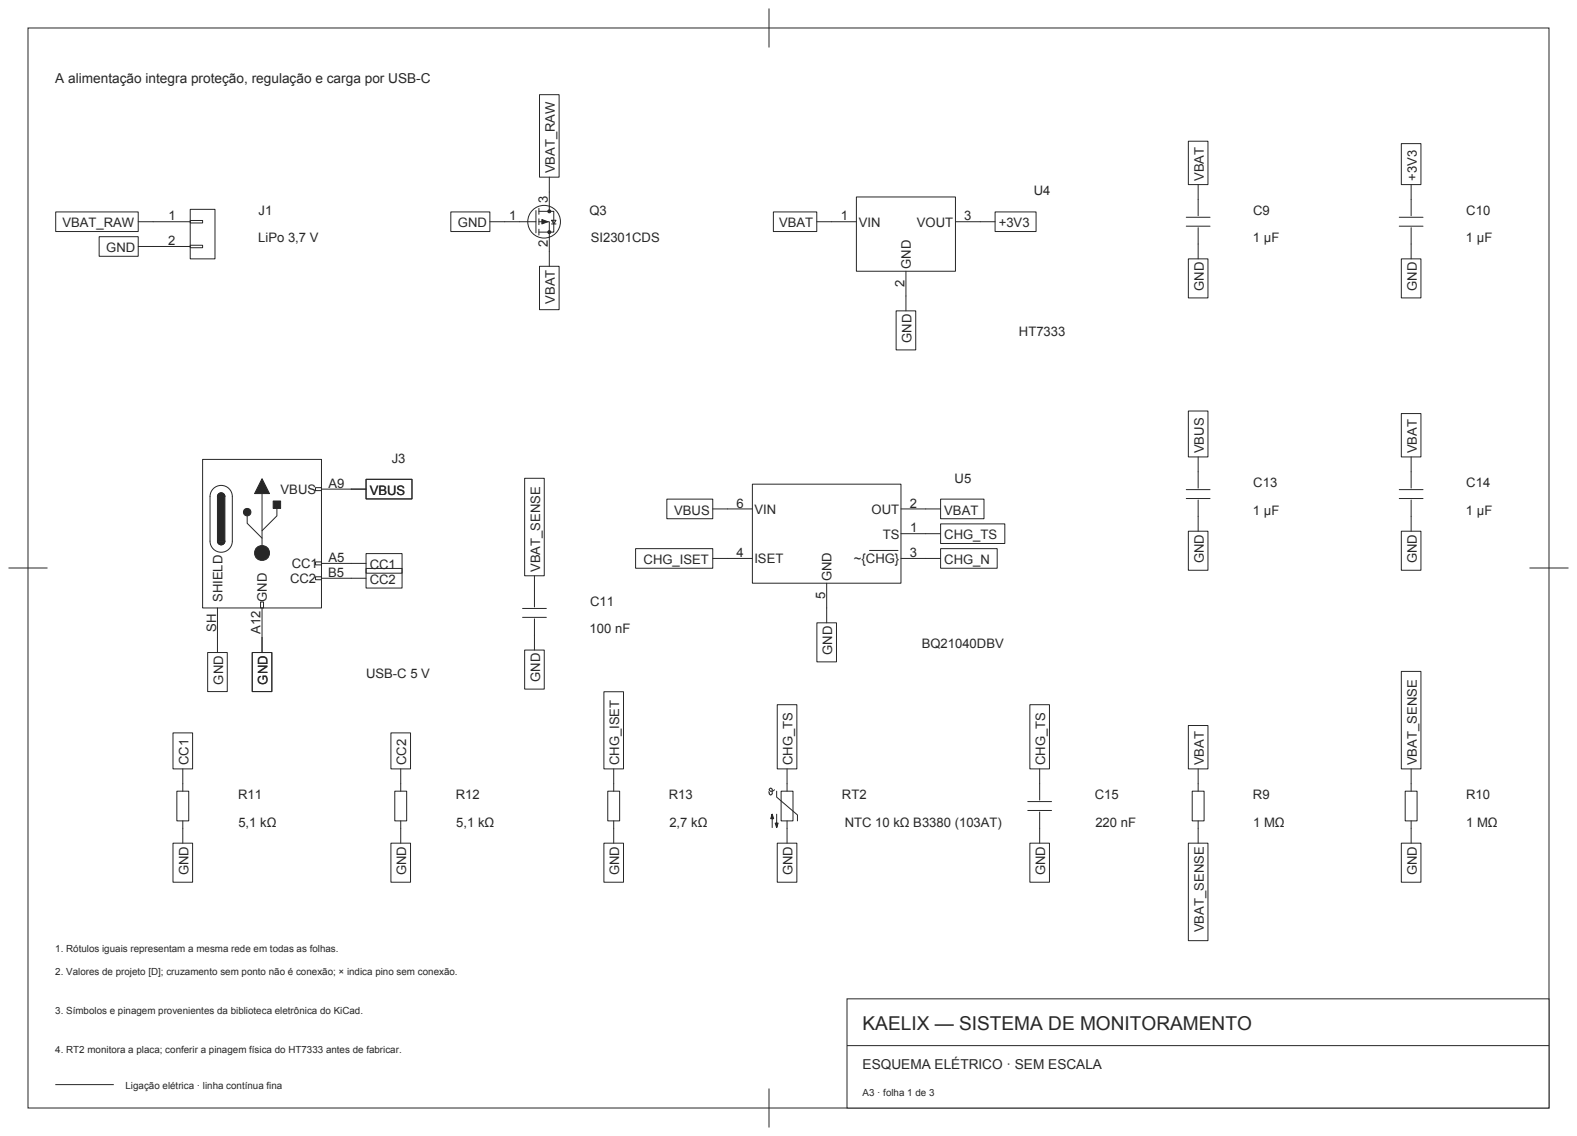
[picture p7: page 1]

A alimentação integra proteção, regulação e carga por USB-C

1. Rótulos iguais representam a mesma rede em todas as folhas.

2. Valores de projeto [D]; cruzamento sem ponto não é conexão; × indica pino sem conexão.

3. Símbolos e pinagem provenientes da biblioteca eletrônica do KiCad.

KAELIX — SISTEMA DE MONITORAMENTO

4. RT2 monitora a placa; conferir a pinagem física do HT7333 antes de fabricar.

ESQUEMA ELÉTRICO · SEM ESCALA

Ligação elétrica · linha contínua fina

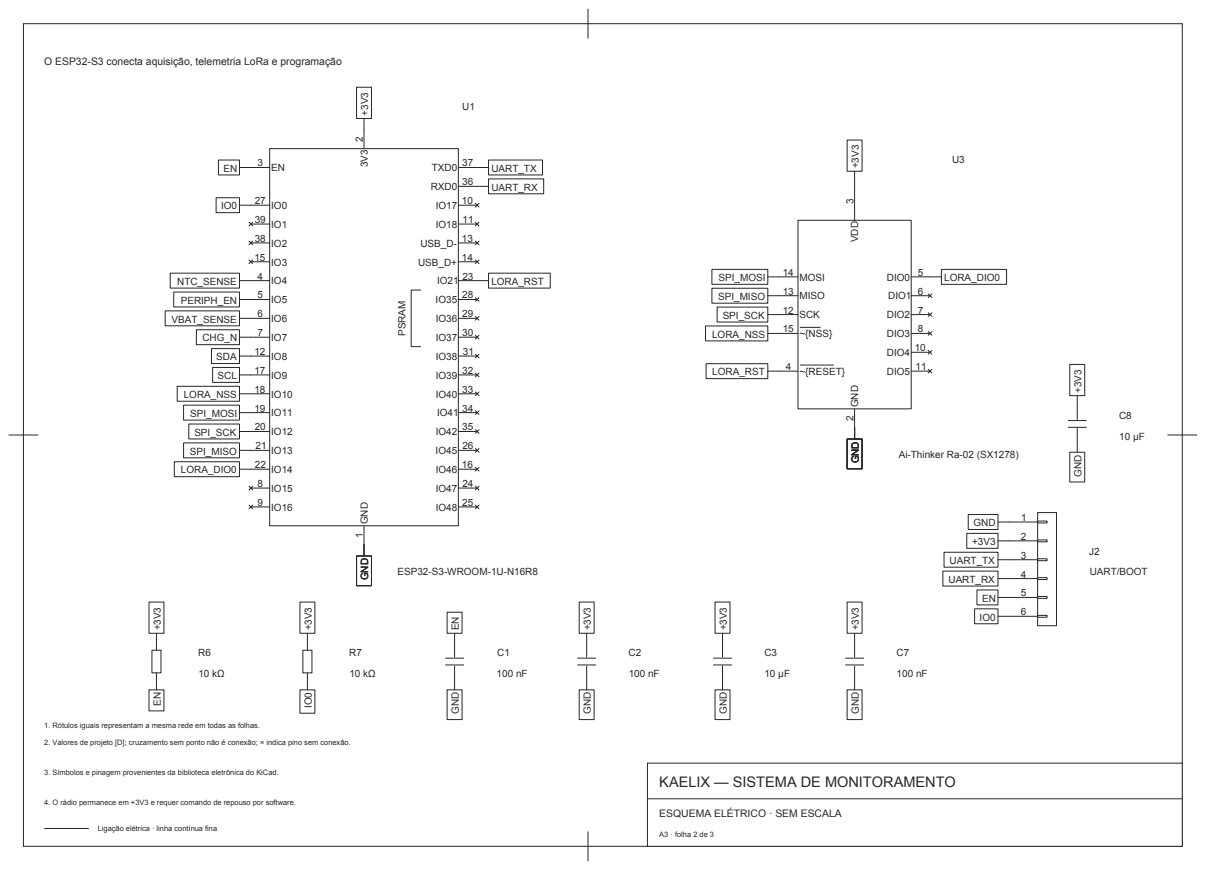
[picture p8: page 2]

O ESP32-S3 conecta aquisição, telemetria LoRa e programação

1. Rótulos iguais representam a mesma rede em todas as folhas.

2. Valores de projeto [D]; cruzamento sem ponto não é conexão; × indica pino sem conexão.

3. Símbolos e pinagem provenientes da biblioteca eletrônica do KiCad.

KAELIX — SISTEMA DE MONITORAMENTO

4. O rádio permanece em +3V3 e requer comando de repouso por software.

# MPU_REGOUT PERIPH_GATE

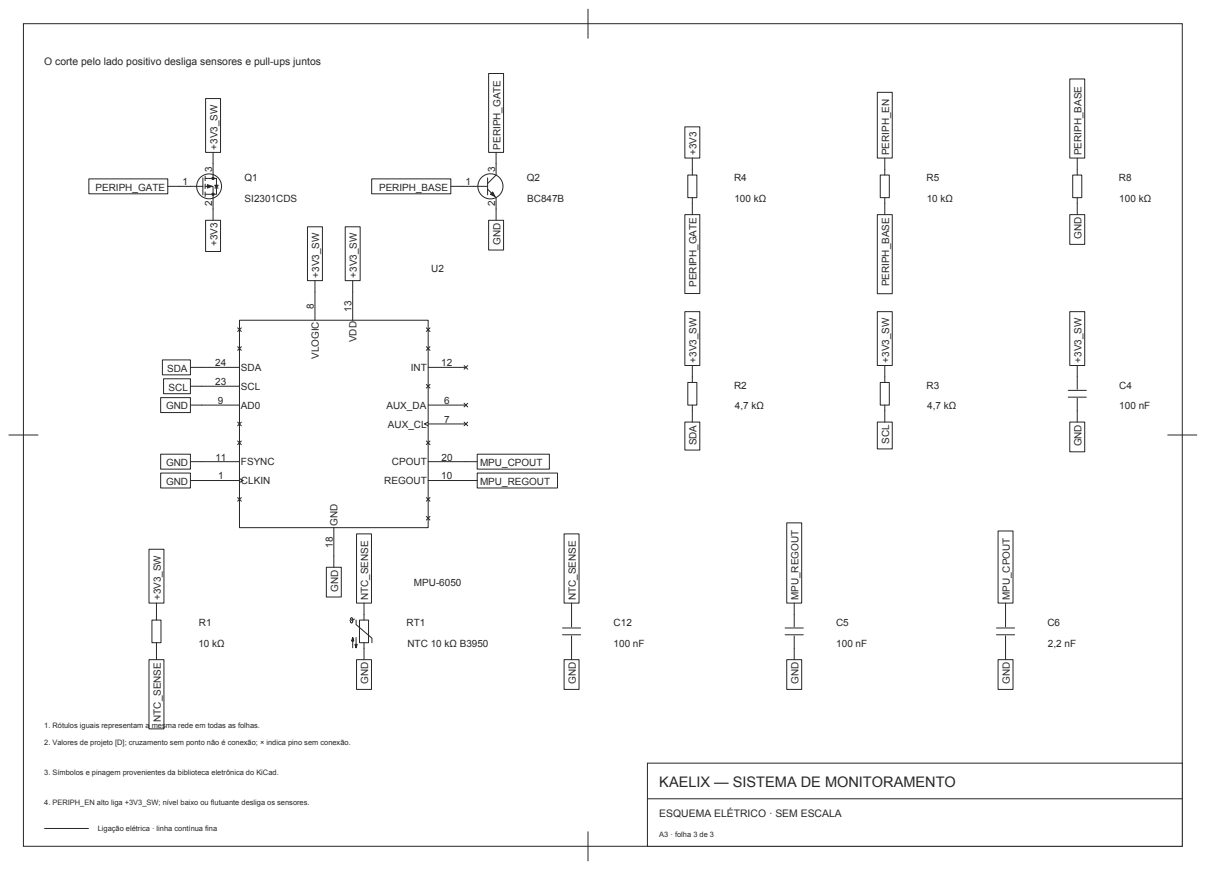
[picture p9: page 3]

O corte pelo lado positivo desliga sensores e pull-ups juntos

1. Rótulos iguais representam a mesma rede em todas as folhas.

2. Valores de projeto [D]; cruzamento sem ponto não é conexão; × indica pino sem conexão.

3. Símbolos e pinagem provenientes da biblioteca eletrônica do KiCad.

KAELIX — SISTEMA DE MONITORAMENTO

4. PERIPH_EN alto liga +3V3_SW; nível baixo ou flutuante desliga os sensores.
