rexionmars/kaelix-firmware/hardware/pcb/v3/prancha/folha1.kicad_sch

## KiCad design hardware/pcb/v3/prancha/folha1.kicad_sch (2026-10-09)

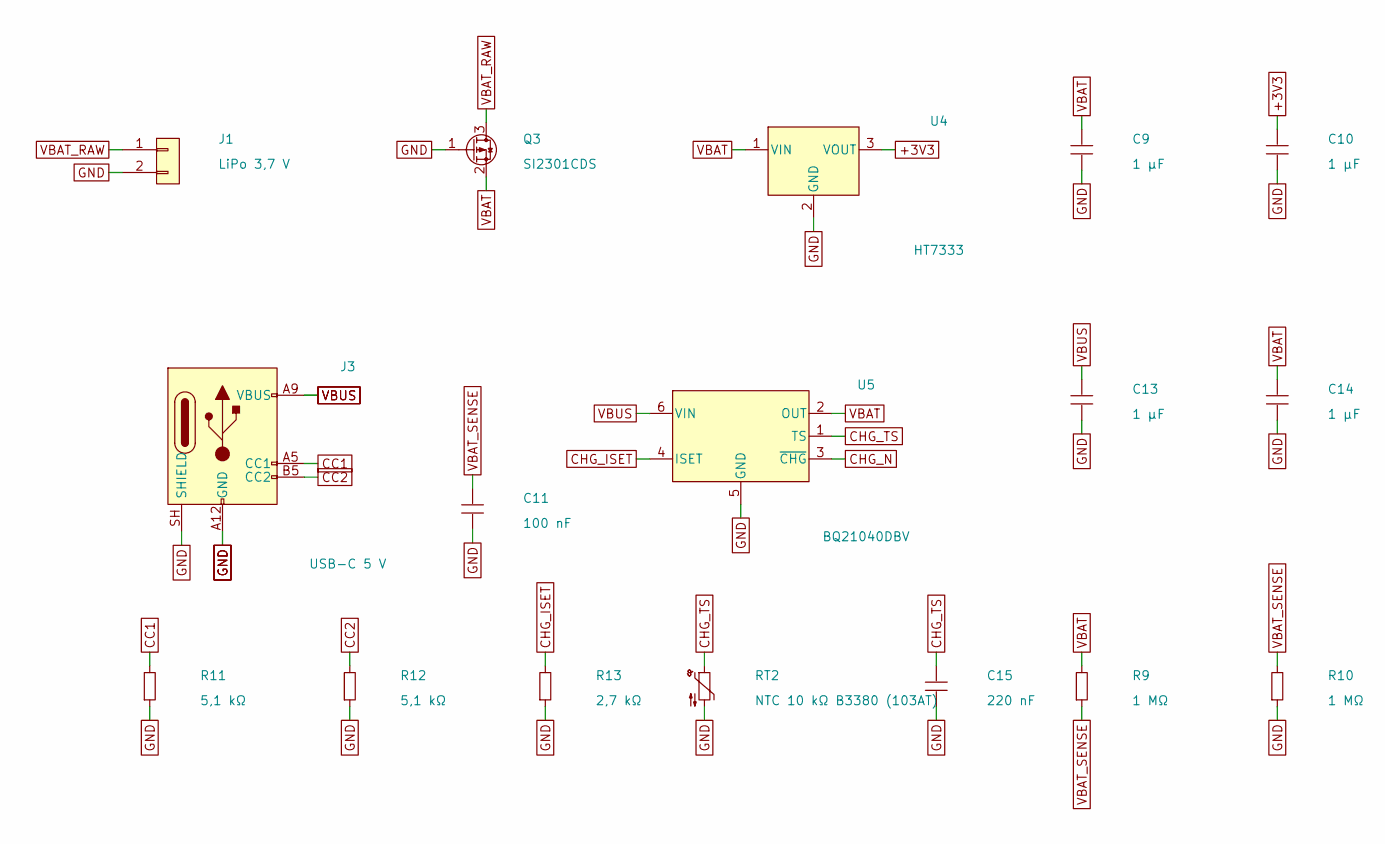
[picture p10: schematic folha1.kicad_sch]

Parts:
C9, C10, C13, C14: 1 µF; C_0805_2012Metric
C11: 100 nF; C_0805_2012Metric
C15: 220 nF; C_0805_2012Metric
J1: LiPo 3,7 V; JST_PH_S2B-PH-SM4-TB_1x02-1MP_P2.00mm_Horizontal
J3: USB-C 5 V; USB_C_Receptacle_GCT_USB4125-xx-x_6P_TopMnt_Horizontal
Q3: SI2301CDS; SOT-23
R9, R10: 1 MΩ; R_0805_2012Metric
R11, R12: 5,1 kΩ; R_0805_2012Metric
R13: 2,7 kΩ; R_0805_2012Metric
RT2: NTC 10 kΩ B3380 (103AT); R_0805_2012Metric
U4: HT7333; SOT-89-3
U5: BQ21040DBV; SOT-23-6

Connections:
+3V3: C10.1, U4.3 (VOUT)
CC1: J3.A5 (CC1), R11.1
CC2: J3.B5 (CC2), R12.1
CHG_ISET: R13.1, U5.4 (ISET)
CHG_N: U5.3 (~CHG)
CHG_TS: C15.1, RT2.1, U5.1 (TS)
GND: C9.2, C10.2, C11.2, C13.2, C14.2, C15.2, J1.2, J3.A12 (GND), J3.B12 (GND), J3.SH (SHIELD), Q3.1 (G), R10.2, R11.2, R12.2, R13.2, RT2.2, U4.2 (GND), U5.5 (GND)
VBAT: C9.1, C14.1, Q3.2 (S), R9.1, U4.1 (VIN), U5.2 (OUT)
VBAT_RAW: J1.1, Q3.3 (D)
VBAT_SENSE: C11.1, R9.2, R10.1
VBUS: C13.1, J3.A9 (VBUS), J3.B9 (VBUS), U5.6 (VIN)
