rexionmars/kaelix-firmware/hardware/pcb/v3/prancha/folha2.kicad_sch

## KiCad design hardware/pcb/v3/prancha/folha2.kicad_sch (2026-10-09)

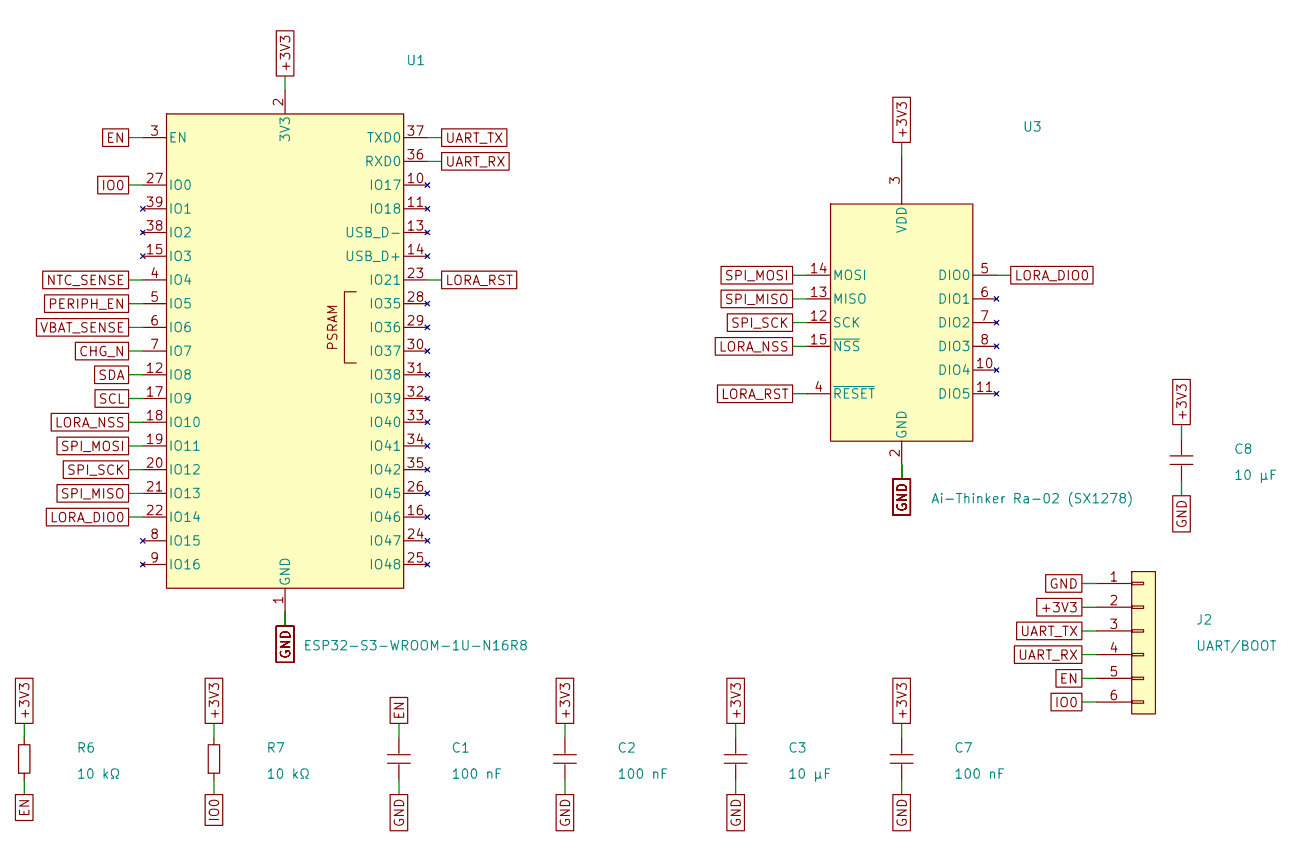
[picture p11: schematic folha2.kicad_sch]

Parts:
C1, C2, C7: 100 nF; C_0805_2012Metric
C3, C8: 10 µF; C_0805_2012Metric
J2: UART/BOOT; PinHeader_1x06_P2.54mm_Vertical
R6, R7: 10 kΩ; R_0805_2012Metric
U1: ESP32-S3-WROOM-1U-N16R8; ESP32-S3-WROOM-1U
U3: Ai-Thinker Ra-02 (SX1278); Ai-Thinker-Ra-01-LoRa

Connections:
+3V3: C2.1, C3.1, C7.1, C8.1, J2.2, R6.1, R7.1, U1.2 (3V3), U3.3 (VDD)
CHG_N: U1.7 (IO7)
EN: C1.1, J2.5, R6.2, U1.3 (EN)
GND: C1.2, C2.2, C3.2, C7.2, C8.2, J2.1, U1.1 (GND), U1.40 (GND), U1.41 (GND), U3.1 (GND), U3.2 (GND), U3.9 (GND), U3.16 (GND)
IO0: J2.6, R7.2, U1.27 (IO0)
LORA_DIO0: U1.22 (IO14), U3.5 (DIO0)
LORA_NSS: U1.18 (IO10), U3.15 (~NSS)
LORA_RST: U1.23 (IO21), U3.4 (~RESET)
NTC_SENSE: U1.4 (IO4)
PERIPH_EN: U1.5 (IO5)
SCL: U1.17 (IO9)
SDA: U1.12 (IO8)
SPI_MISO: U1.21 (IO13), U3.13 (MISO)
SPI_MOSI: U1.19 (IO11), U3.14 (MOSI)
SPI_SCK: U1.20 (IO12), U3.12 (SCK)
UART_RX: J2.4, U1.36 (RXD0)
UART_TX: J2.3, U1.37 (TXD0)
VBAT_SENSE: U1.6 (IO6)
