rexionmars/kaelix-firmware/hardware/pcb/v3/prancha/folha3.kicad_sch

## KiCad design hardware/pcb/v3/prancha/folha3.kicad_sch (2026-10-09)

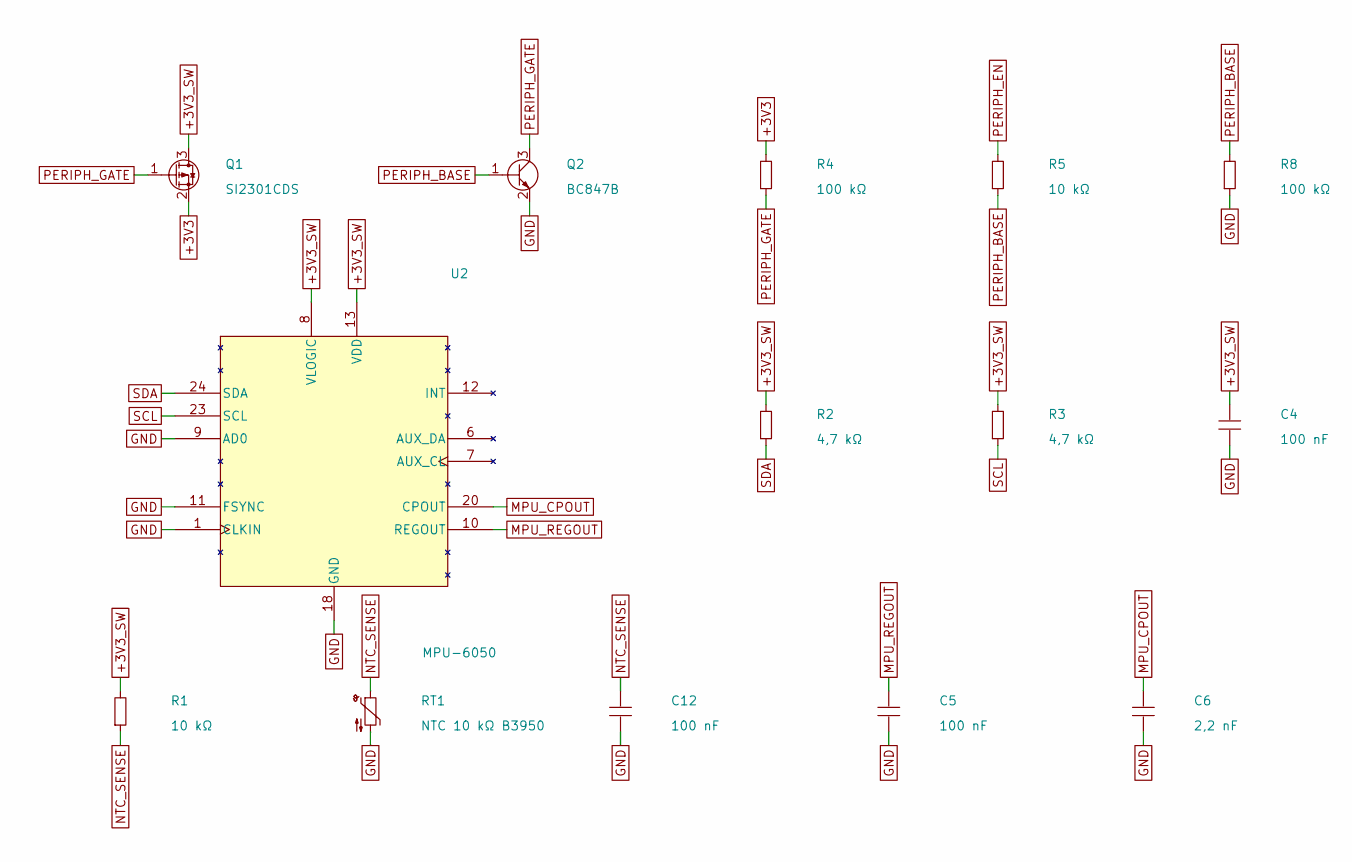
[picture p12: schematic folha3.kicad_sch]

Parts:
C4, C5, C12: 100 nF; C_0805_2012Metric
C6: 2,2 nF; C_0805_2012Metric
Q1: SI2301CDS; SOT-23
Q2: BC847B; SOT-23
R1, R5: 10 kΩ; R_0805_2012Metric
R2, R3: 4,7 kΩ; R_0805_2012Metric
R4, R8: 100 kΩ; R_0805_2012Metric
RT1: NTC 10 kΩ B3950; R_0805_2012Metric
U2: MPU-6050; InvenSense_QFN-24_4x4mm_P0.5mm

Connections:
+3V3: Q1.2 (S), R4.1
+3V3_SW: C4.1, Q1.3 (D), R1.1, R2.1, R3.1, U2.8 (VLOGIC), U2.13 (VDD)
GND: C4.2, C5.2, C6.2, C12.2, Q2.2 (E), R8.2, RT1.2, U2.1 (CLKIN), U2.9 (AD0), U2.11 (FSYNC), U2.18 (GND)
MPU_CPOUT: C6.1, U2.20 (CPOUT)
MPU_REGOUT: C5.1, U2.10 (REGOUT)
NTC_SENSE: C12.1, R1.2, RT1.1
PERIPH_BASE: Q2.1 (B), R5.2, R8.1
PERIPH_EN: R5.1
PERIPH_GATE: Q1.1 (G), Q2.3 (C), R4.2
SCL: R3.2, U2.23 (SCL)
SDA: R2.2, U2.24 (SDA)
