rexionmars/kaelix-firmware/(commit log)

2026-10-09 fix(hardware): standardize v3 schematic sheets using KiCad
    [folha1.kicad_sch, folha2.kicad_sch, folha3.kicad_sch]
2026-10-11 feat(firmware): implement vibration acquisition and C3 LoRa receiver
    Add MPU6050/MPU6515 FIFO acquisition, an S3 bench environment without NTC, and a C3 receiver for v2 packets. Include isolated SPI probes, receiver diagnostics, timestamped logs, decoder tests, and wiring instructions.
    [lora.cpp, lora_config.h, lora_probe.cpp, main.cpp, packet_decode.h]
2026-10-11 docs(tcc): record device communication plan and receiver bench log
2026-11-01 feat(firmware): run the ESP32-C3 as the transmitter device
    Add the esp32-c3-device environment and move the pin map to device_pins.h,
    so the S3 and C3 profiles share the acquisition and LoRa code. The RTC
    watchdog goes through a C bridge that compiles on both targets. The S3 setup
    stays documented as the previous assembly.
2026-11-01 feat(figures): add detection data and regenerate figures 1 and 2
    Add the false alarm tables on data outside training and the per-class
    detection tables. Figures 1 and 2 now use decimal commas and Portuguese
    labels. Existing CSV values are unchanged; they only gained columns.
    [fig2a_sem_media.csv, fig2d_contamination.csv, fig2d_fora_do_treino.csv, fig2e_roc.csv, tab_deteccao_classes.csv, tab_deteccao_limiar.csv]
2026-11-01 docs(tcc): move to the iCEV template and limit the scope to the firmware
    Replace tcc.tex with main.tex and a split preamble, following the iCEV layout
    and the ABNT standards where the two conflict. References follow NBR 6023:2025
    through a local bibliography style. Board, enclosure, thermal and battery
    design leave the text and become future work. Theory and related work become a
    single section, the introduction is numbered, and the conclusions evaluate
    each hypothesis. Add the writing guides.
2026-11-01 docs: organize docs/ by subject
    Move the LaTeX reports to docs/relatorios, the engineering documents and the
    C3 notes to docs/engenharia, and the writing guides to docs/guias. The reports
    compile again: their image paths assume a folder one level below docs/, and
    all 18 images were unreachable from docs/local_report/tex.
    Update the references in comments and docs, including those that still pointed
    to docs/device and to documents directly under docs/. Rewrite the README tree,
    which omitted hardware, TCC, contracts, logs and include, and correct the test
    counts and the statement that no suite covers src/.
    [gen_involucro.py, gen_pcb.py, machine_state.h, main.cpp]
2026-11-01 refactor(hardware): move the scripts to hardware/scripts
    The 16 generators and analyses sat at the root of hardware/ next to their
    outputs. AQUI still names the scripts folder, used to find sibling scripts, and
    the new HW names hardware/, used to find the data. The generators produce the
    same v1, v2 and v3 boards, byte for byte, except for the timestamps in the
    reports and the netlist and the STEP export.
    build-hardware.sh now runs the generators in the project environment. It called
    the system python3, and gen_pcb.py failed where that had no numpy.
    [check_3d.py, fem_caminho.py, fem_figuras.py, fem_modal.py, fem_montagem.py, gen_3dmodels.py, gen_involucro.py]
